versioduo/spot/hardware/spot.pdf

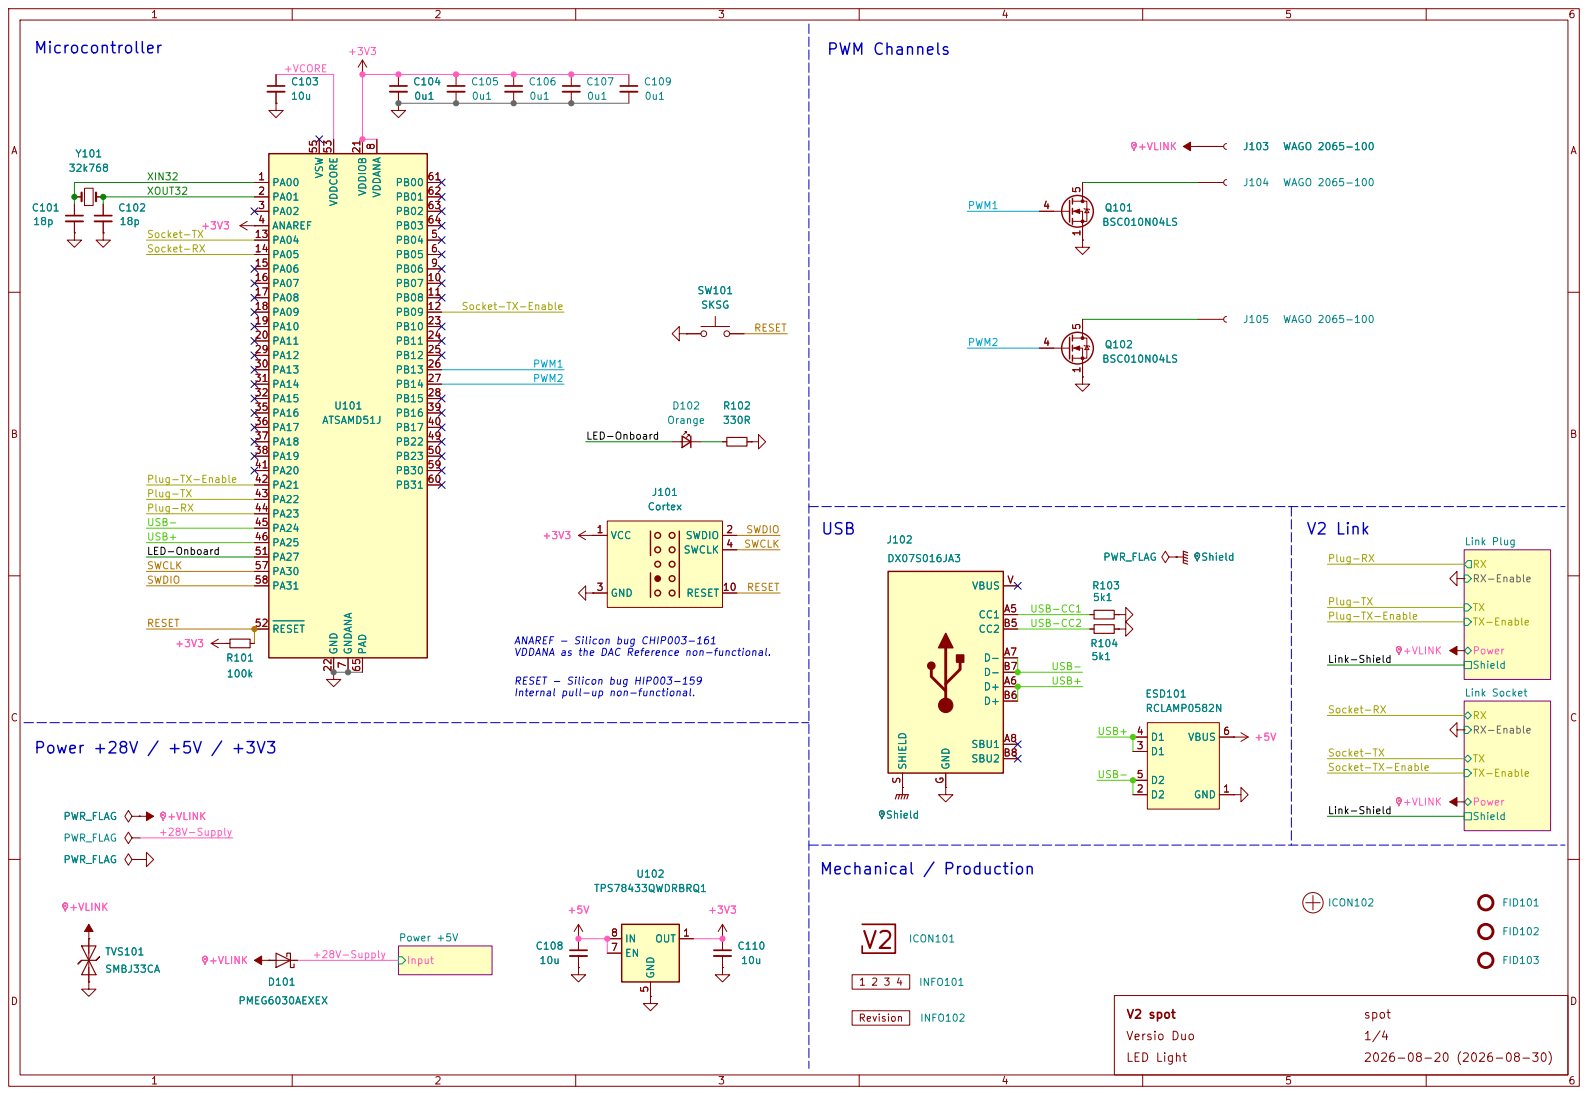
[picture p1: page 1]

TX-Enable Power Shield

Link-Shield Socket-RX

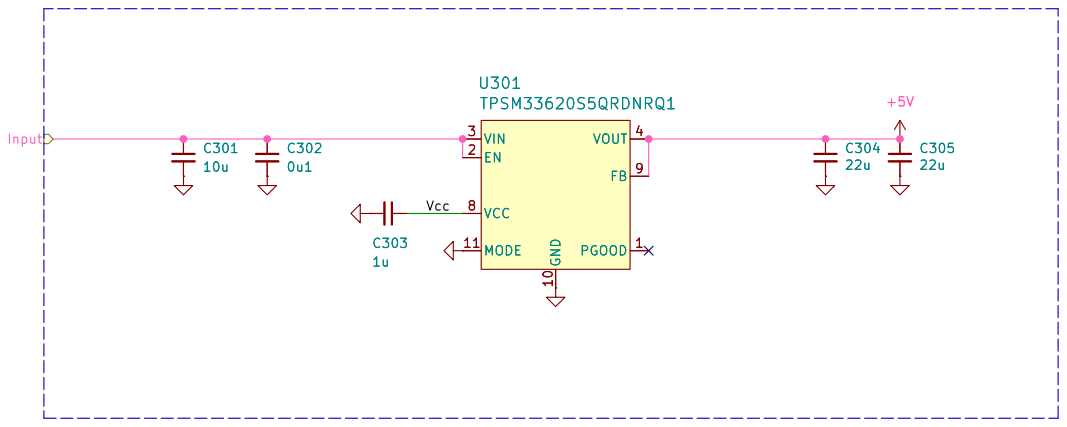
[picture p2: page 2]

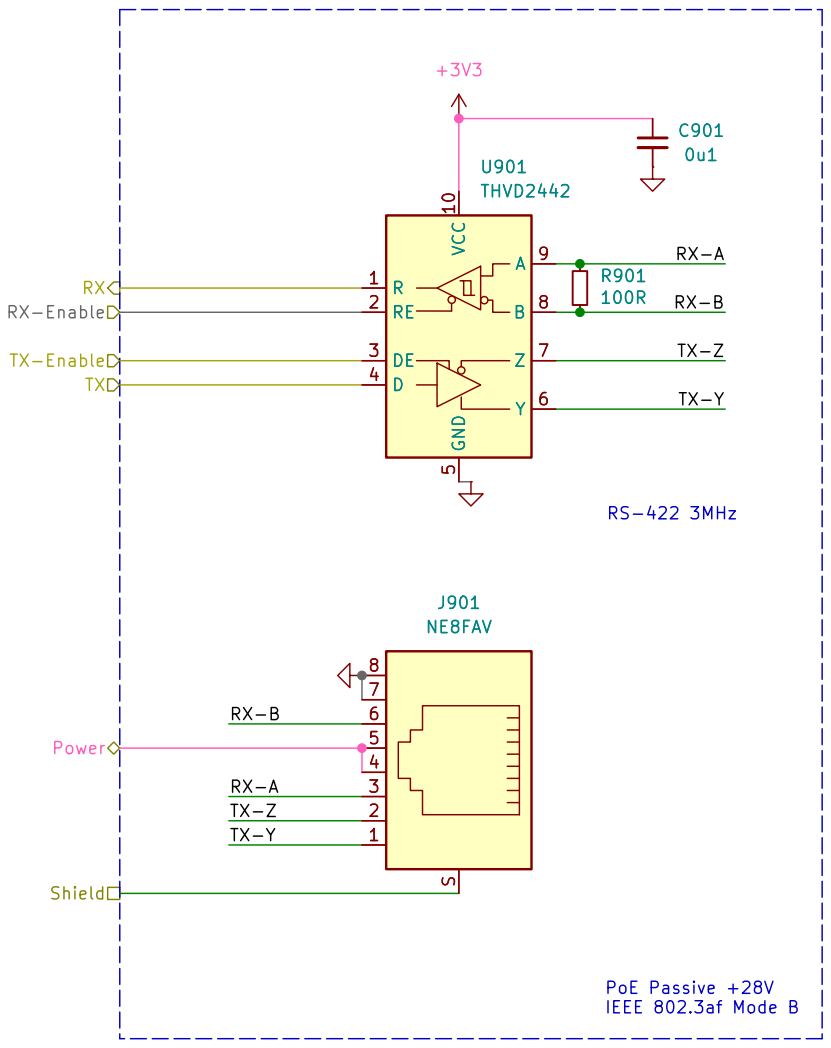
[picture p3: page 3]

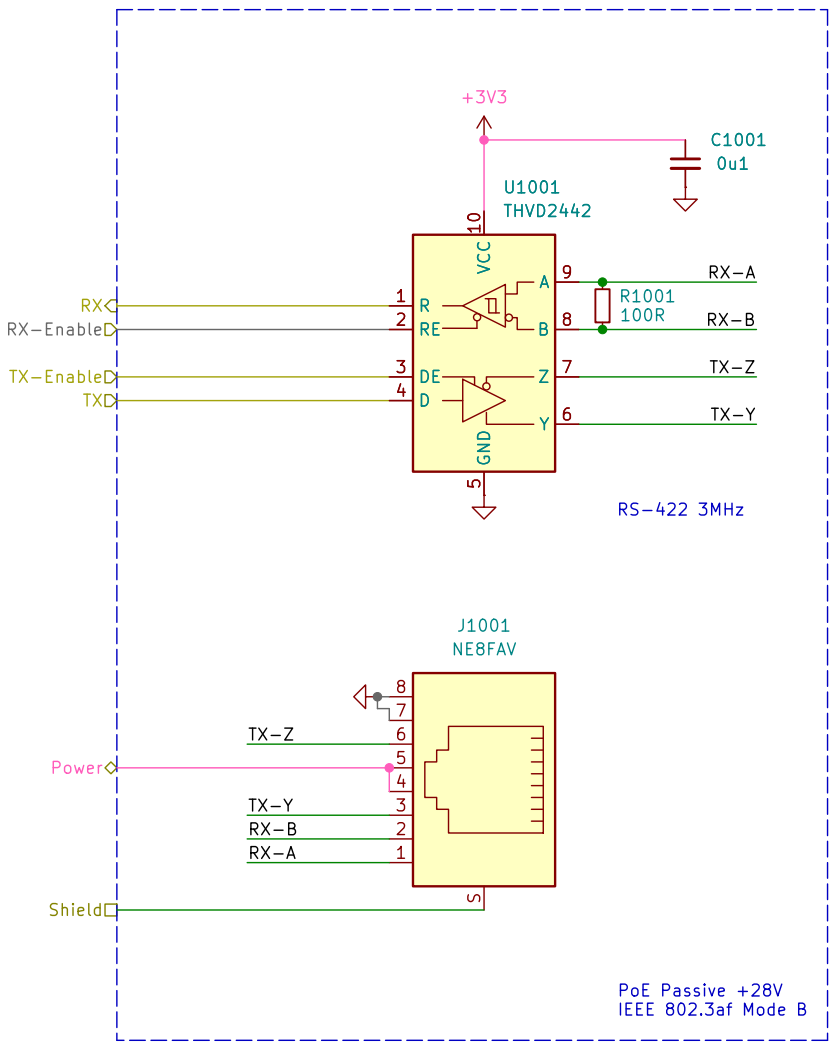
[picture p4: page 4]

TX-Enable RX RX-Enable
