versioduo/spot/hardware/spot.kicad_pcb

## KiCad design hardware/spot.kicad_pcb (2026-08-30)

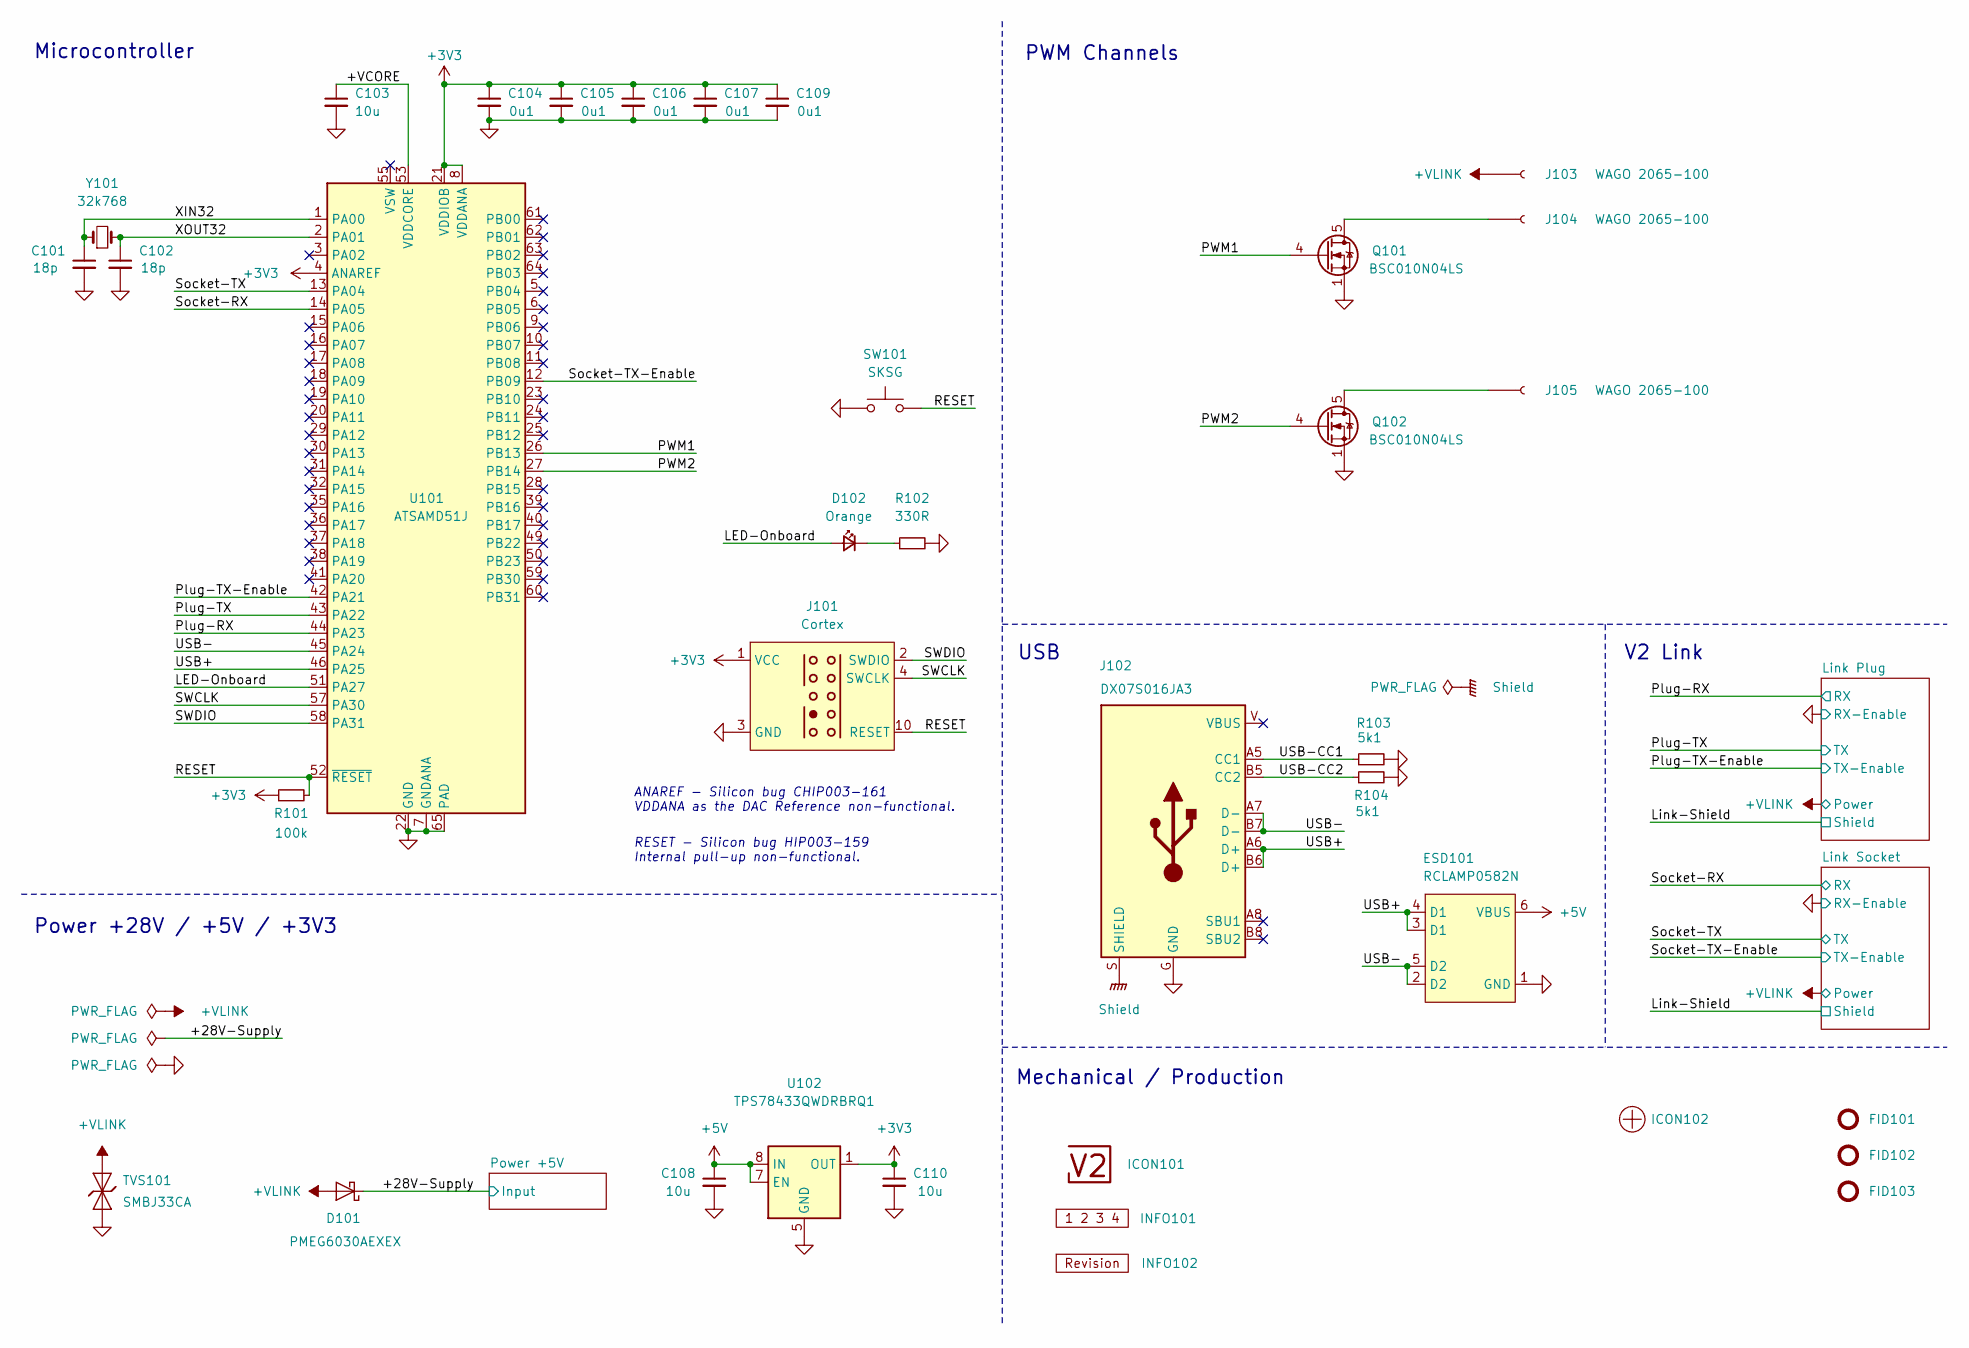
[picture p5: schematic spot.kicad_sch, V2 spot]

Parts:
C101, C102: 18p; C_1608; Rating 50V; Mouser 810-CGA3E2C0G1H180J
C103: 10u; C_1608; Rating 10V; Mouser 810-C1608X6S1A106M
C104, C105, C106, C107, C109: 0u1; C_1608; Rating 50V; Mouser 810-CGA3E2X7R1H104MA
C108, C110: 10u; C_2012; Rating 25V; Mouser 810-C2012X5R1E106K
D101: PMEG6030AEXEX; D_SOD-123HP; Rating 60V; Mouser 771-PMEG6030AEXEX
D102: Orange; LED_1608; Rating 605nm; Mouser 755-SML-D12D1WT86
ESD101: RCLAMP0582N; SLP1210N6; Rating 20kV; Mouser 947-RCLAMP0582N.TCT
FID101, FID102, FID103: Fiducial_Paste; Fiducial_0.5mm_Mask1mm_Paste
ICON101: V2-logo; Logo_Small
ICON102: Plus; Plus_Small
INFO101: Layer_Numbers-6
INFO102: Revision
J101: Cortex
J102: DX07S016JA3; JAE_DX07S016JA3; Rating USB2.0; Mouser 656-DX07S016JA3R1500
J103, J104, J105: WAGO 2065-100; 2065-100; Rating 9A
Q101, Q102: BSC010N04LS; TDSON-8-FL; Rating 40V; Mouser 726-BSC010N04LS
R101: 100k; R_1608; Rating 100mW; Mouser 71-CRCW0603100KFKEAC
R102: 330R; R_1608; Rating 100mW; Mouser 71-CRCW0603330RFKEAC
R103, R104: 5k1; R_1608; Rating 100mW; Mouser 71-CRCW06035K10FKEAC
SW101: SKSG; Rating 1.6N; Mouser 688-SKSGACE010
TVS101: SMBJ33CA; D_SMB; Rating 33V; Mouser 652-SMBJ33CA-Q
U101: ATSAMD51J; QFN-64-1EP_9x9mm_P0.5mm_EP4.8x4.8mm_ThermalVias; Rating Cortex-M4F; Mouser 556-ATSAMD51J19AMU
U102: TPS78433QWDRBRQ1; VSON-8-1_3x3mm_P0.65_EP1.65x2.4mm; Rating 300mA; Mouser 595-TPS78433QWDRBRQ1
Y101: 32k768; Crystal_SMD_3215-2Pin_3.2x1.5mm; Rating 10ppm; Mouser 815-ABS0716632.768KT

Connections:
+3V3: C104.1, C105.1, C106.1, C107.1, C109.1, C110.1, J101.1 (VCC), R101.1, U101.4 (ANAREF), U101.8 (VDDANA), U101.21 (VDDIOB), U101.34 (VDDIO), U101.48 (VDDIO), U101.56 (VDDIO), U102.1 (OUT); also elsewhere on the board
+5V: C108.1, ESD101.6 (VBUS), U102.6 (EN), U102.7 (EN), U102.8 (IN); also elsewhere on the board
/+28V-Supply: D101.1 (K); also elsewhere on the board
/+VCORE: C103.1, U101.53 (VDDCORE)
/+VLINK: D101.2 (A), J103.1, TVS101.2 (A); also elsewhere on the board
/LED-Onboard: D102.2 (A), U101.51 (PA27)
/PWM1: Q101.4 (G), U101.26 (PB13)
/PWM2: Q102.4 (G), U101.27 (PB14)
/Plug-RX: U101.44 (PA23); also elsewhere on the board
/Plug-TX: U101.43 (PA22); also elsewhere on the board
/Plug-TX-Enable: U101.42 (PA21); also elsewhere on the board
/RESET: J101.10 (RESET), R101.2, SW101.2, U101.52 (~RESET)
/SWCLK: J101.4 (SWCLK), U101.57 (PA30)
/SWDIO: J101.2 (SWDIO), U101.58 (PA31)
/Shield: J102.S (SHIELD)
/Socket-RX: U101.14 (PA05); also elsewhere on the board
/Socket-TX: U101.13 (PA04); also elsewhere on the board
/Socket-TX-Enable: U101.12 (PB09); also elsewhere on the board
/USB+: ESD101.3 (D1), ESD101.4 (D1), J102.A6 (D+), J102.B6 (D+), U101.46 (PA25)
/USB-: ESD101.2 (D2), ESD101.5 (D2), J102.A7 (D-), J102.B7 (D-), U101.45 (PA24)
/USB-CC1: J102.A5 (CC1), R103.1
/USB-CC2: J102.B5 (CC2), R104.1
/XIN32: C101.1, U101.1 (PA00), Y101.1
/XOUT32: C102.1, U101.2 (PA01), Y101.2
GND: C101.2, C102.2, C103.2, C104.2, C105.2, C106.2, C107.2, C108.2, C109.2, C110.2, ESD101.1 (GND), J101.3 (GND), J101.5 (GND), J102.G (GND), Q101.1 (S), Q102.1 (S), R102.2, R103.2, R104.2, SW101.1, TVS101.1 (K), U101.7 (GNDANA), U101.22 (GND), U101.33 (GND), U101.47 (GND), U101.54 (GND), U101.65 (PAD), U102.5 (GND), U102.9 (GND); also elsewhere on the board
unnamed: D102.1 (K), R102.1
unnamed: J104.1, Q101.5 (D)
unnamed: J105.1, Q102.5 (D)

Notes on the sheet:
 ANAREF - Silicon bug CHIP003-161 VDDANA as the DAC Reference non-functional.
PWM Channels
RESET -  Silicon bug HIP003-159 Internal pull-up non-functional.
USB
Mechanical / Production
Power +28V / +5V / +3V3
V2 Link
Microcontroller

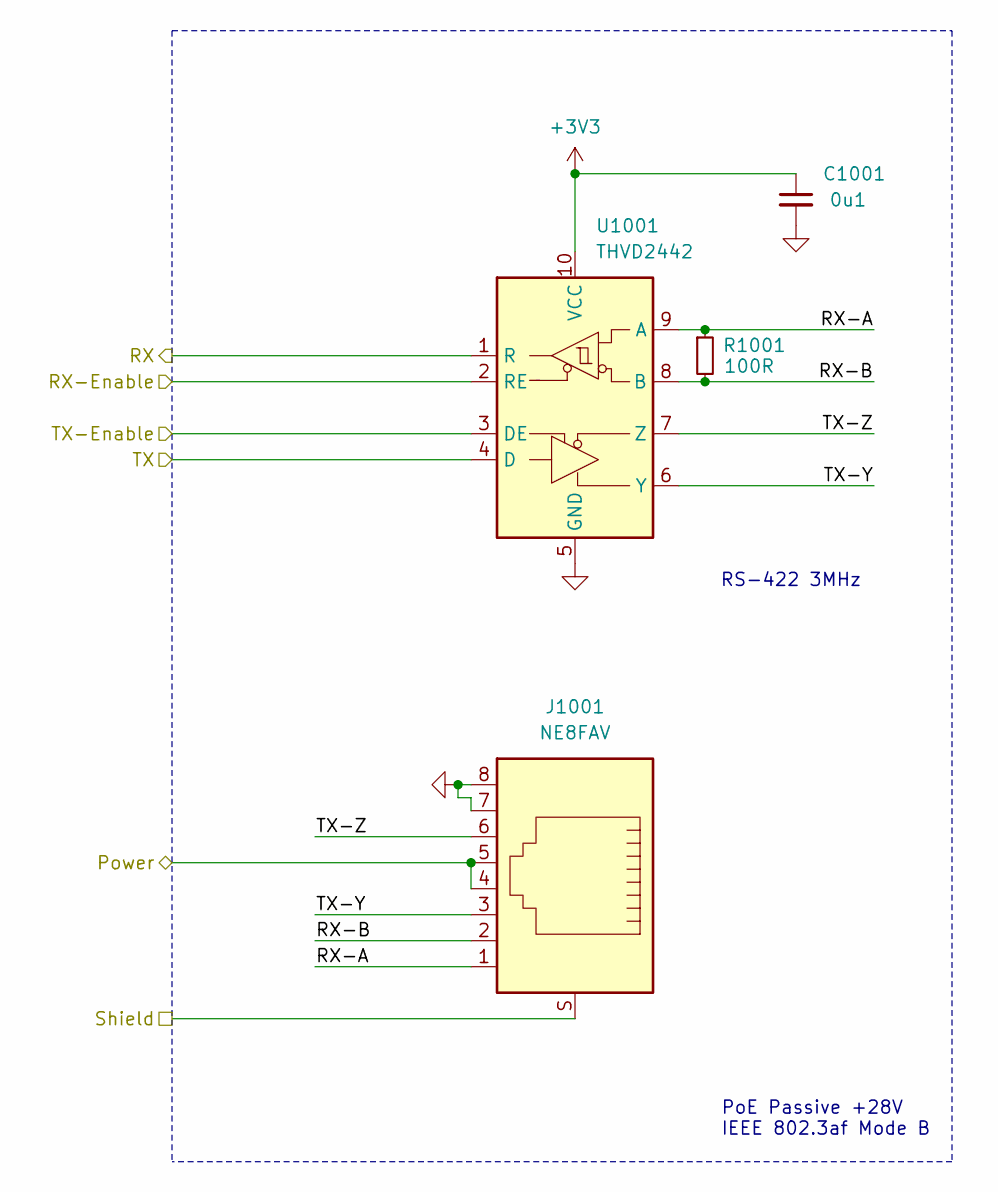
[picture p6: schematic Link-Socket.kicad_sch, V2 spot]

Parts:
C1001: 0u1; C_1608; Rating 50V; Mouser 810-CGA3E2X7R1H104MA
J1001: NE8FAV; Rating CAT5e; Mouser 568-NE8FAV-SD
R1001: 100R; R_1608; Rating 330mW; Mouser 71-CRCW0603100RFKEAH
U1001: THVD2442; VSON-10-4-1EP_3x3mm_P0.5mm_EP1.65x2.4mm_ThermalVias; Rating 20Mbps; Mouser 595-THVD2442DRCR

Connections:
+3V3: C1001.1, U1001.10 (VCC); also elsewhere on the board
/+VLINK: J1001.4, J1001.5; also elsewhere on the board
/Link Socket/RX-A: J1001.1, R1001.1, U1001.9 (A)
/Link Socket/RX-B: J1001.2, R1001.2, U1001.8 (B)
/Link Socket/TX-Y: J1001.3, U1001.6 (Y)
/Link Socket/TX-Z: J1001.6, U1001.7 (Z)
/Link-Shield: J1001.S; also elsewhere on the board
/Socket-RX: U1001.1 (R); also elsewhere on the board
/Socket-TX: U1001.4 (D); also elsewhere on the board
/Socket-TX-Enable: U1001.3 (DE); also elsewhere on the board
GND: C1001.2, J1001.7, J1001.8, U1001.2 (RE), U1001.5 (GND), U1001.11 (GND); also elsewhere on the board

Notes on the sheet:
PoE Passive +28V IEEE 802.3af Mode B
RS-422 3MHz

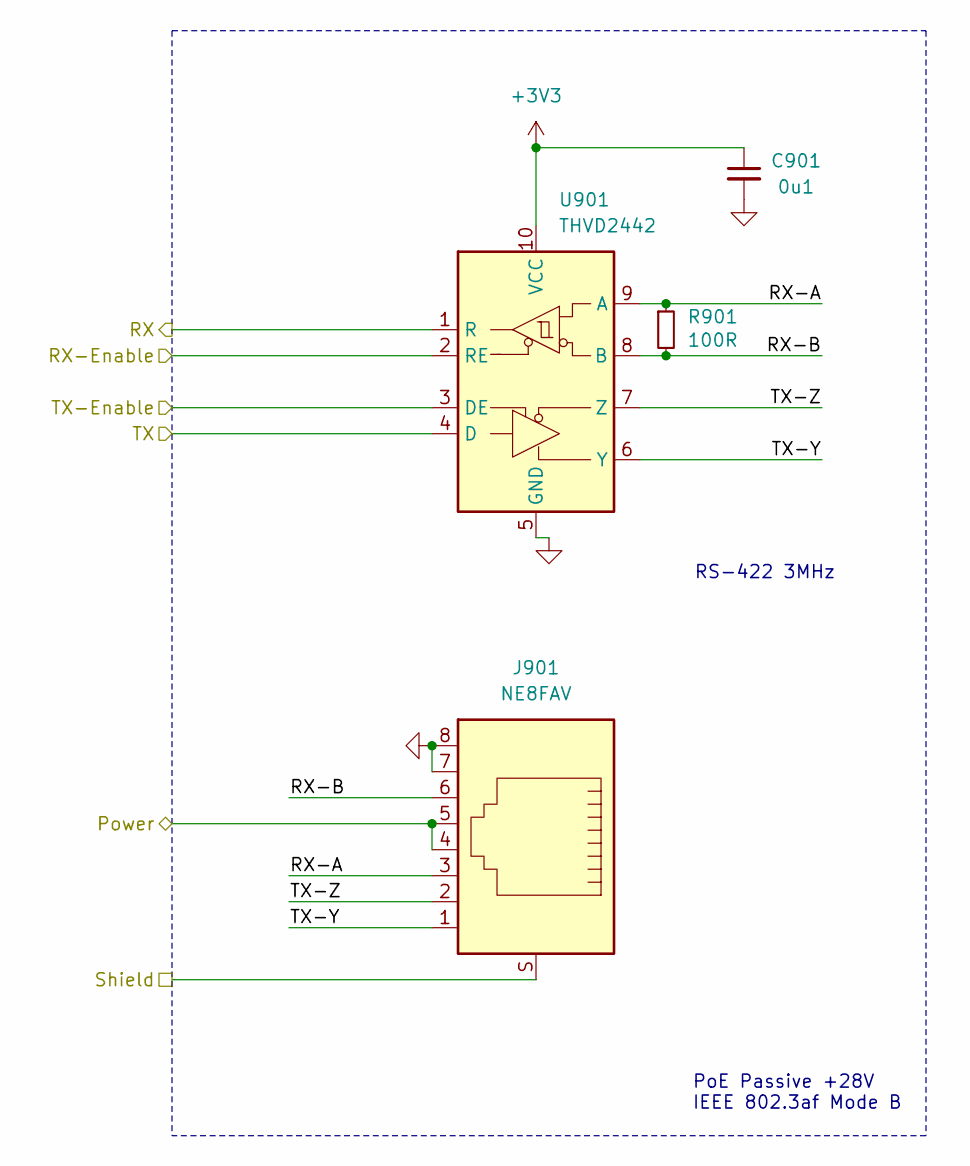
[picture p7: schematic Link-Plug.kicad_sch, V2 spot]

Parts:
C901: 0u1; C_1608; Rating 50V; Mouser 810-CGA3E2X7R1H104MA
J901: NE8FAV; Rating CAT5e; Mouser 568-NE8FAV-SD
R901: 100R; R_1608; Rating 330mW; Mouser 71-CRCW0603100RFKEAH
U901: THVD2442; VSON-10-4-1EP_3x3mm_P0.5mm_EP1.65x2.4mm_ThermalVias; Rating 20Mbps; Mouser 595-THVD2442DRCR

Connections:
+3V3: C901.1, U901.10 (VCC); also elsewhere on the board
/+VLINK: J901.4, J901.5; also elsewhere on the board
/Link Plug/RX-A: J901.3, R901.1, U901.9 (A)
/Link Plug/RX-B: J901.6, R901.2, U901.8 (B)
/Link Plug/TX-Y: J901.1, U901.6 (Y)
/Link Plug/TX-Z: J901.2, U901.7 (Z)
/Link-Shield: J901.S; also elsewhere on the board
/Plug-RX: U901.1 (R); also elsewhere on the board
/Plug-TX: U901.4 (D); also elsewhere on the board
/Plug-TX-Enable: U901.3 (DE); also elsewhere on the board
GND: C901.2, J901.7, J901.8, U901.2 (RE), U901.5 (GND), U901.11 (GND); also elsewhere on the board

Notes on the sheet:
RS-422 3MHz
PoE Passive +28V IEEE 802.3af Mode B

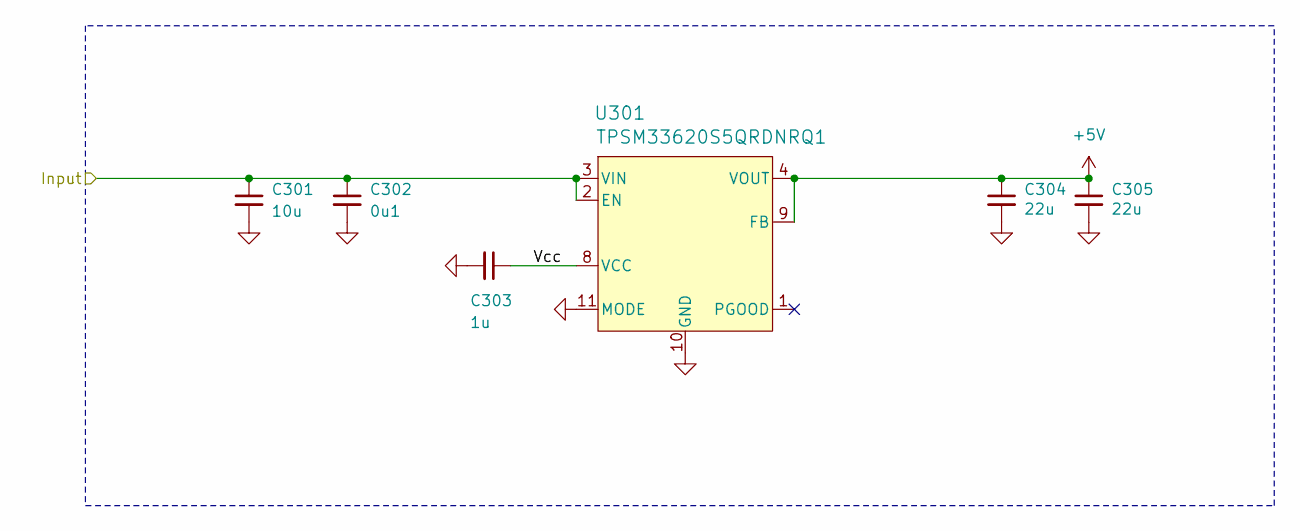
[picture p8: schematic Power-DCDC.kicad_sch, V2 spot]

Parts:
C301: 10u; C_3225; Rating 50V; Mouser 810-CNC6P1X7R1H106K2
C302: 0u1; C_1608; Rating 50V; Mouser 810-CGA3E2X7R1H104MA
C303: 1u; C_1608; Rating 50V; Mouser 810-CGA3E3X7R1H105K0
C304, C305: 22u; C_3225; Rating 25V; Mouser 810-CGA6P3X7R1E226M5
U301: TPSM33620S5QRDNRQ1; QFN-11; Rating 2A; Mouser 595-SM33620S5QRDNRQ1

Connections:
+5V: C304.1, C305.1, U301.4 (VOUT), U301.9 (FB); also elsewhere on the board
/+28V-Supply: C301.1, C302.1, U301.2 (EN), U301.3 (VIN); also elsewhere on the board
/Power +5V/Vcc: C303.1, U301.8 (VCC)
GND: C301.2, C302.2, C303.2, C304.2, C305.2, U301.10 (GND), U301.11 (MODE); also elsewhere on the board

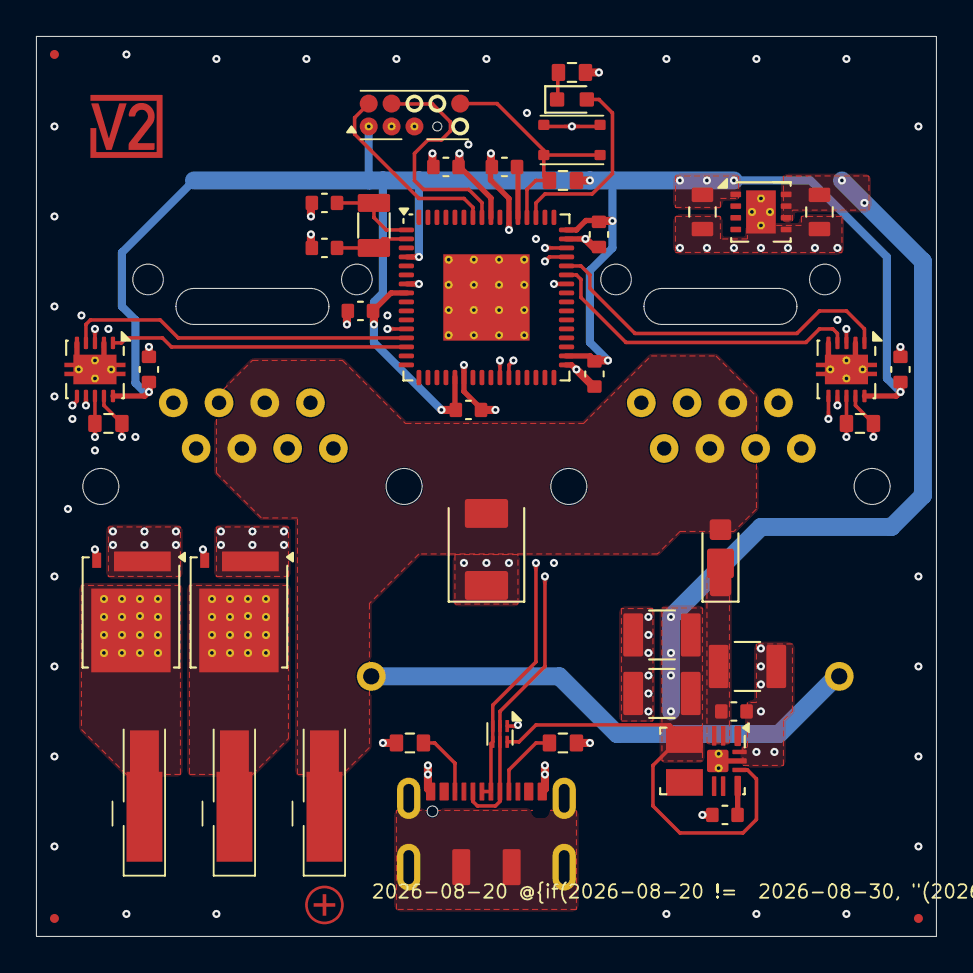
[picture p9: board spot.kicad_pcb from above]

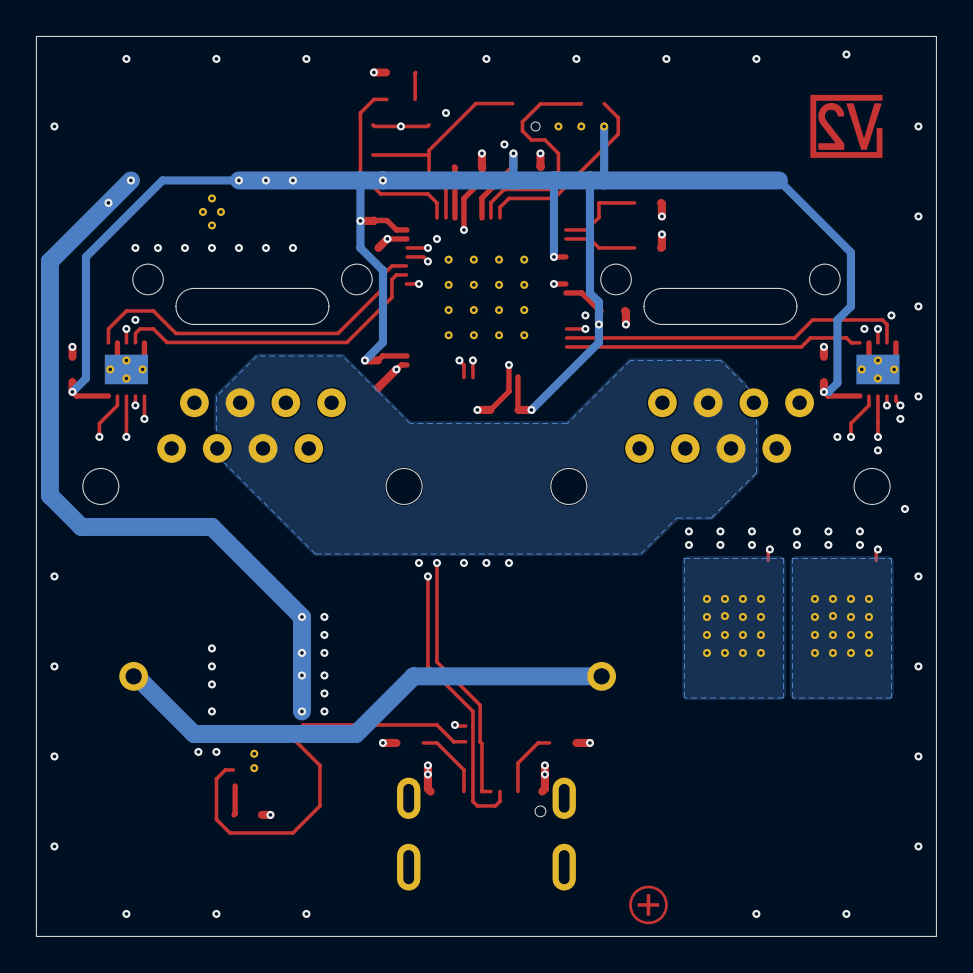
[picture p10: board spot.kicad_pcb from below]

Board: 6 copper layers, 50.0 x 50.0 mm, 50 parts (2 on the bottom side), 37 nets.
