versioduo/spot/(commit log)

2026-07-20 Update board
2026-08-21 Update LDO
    [LinkPlug.kicad_sch, LinkSocket.kicad_sch, PowerSupply.kicad_sch, spot.kicad_pcb, spot.kicad_sch]
